alizojran/sensor/float_flowmeter_sim/float_redesign_cfd.png

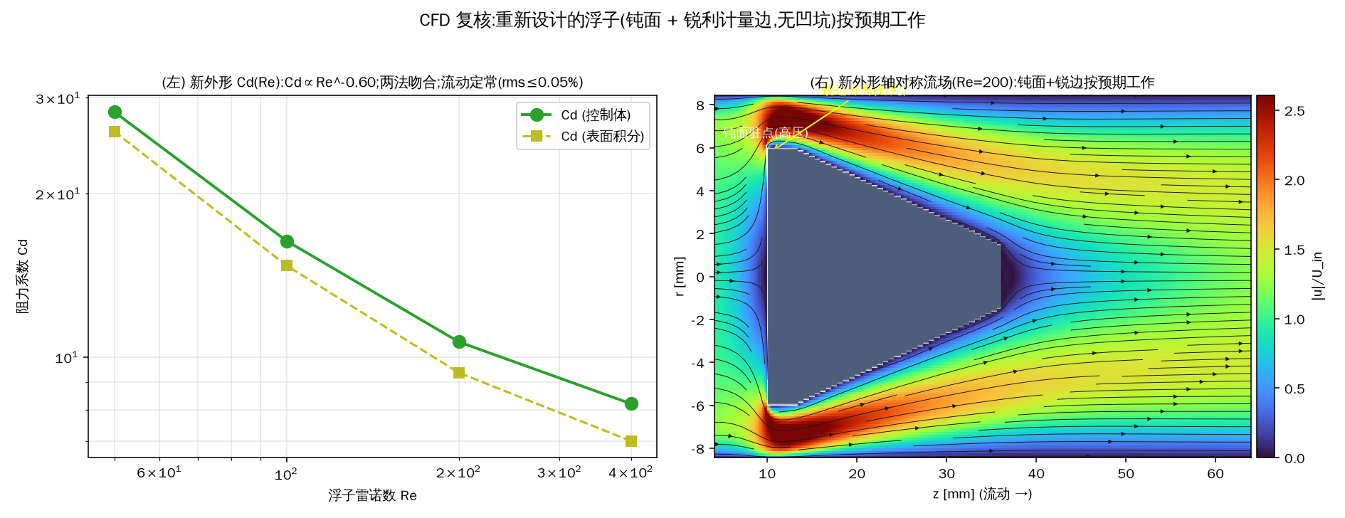
float_flowmeter_sim/float_redesign_cfd.png
