alizojran/sensor/float_flowmeter_sim/float_axisym.png

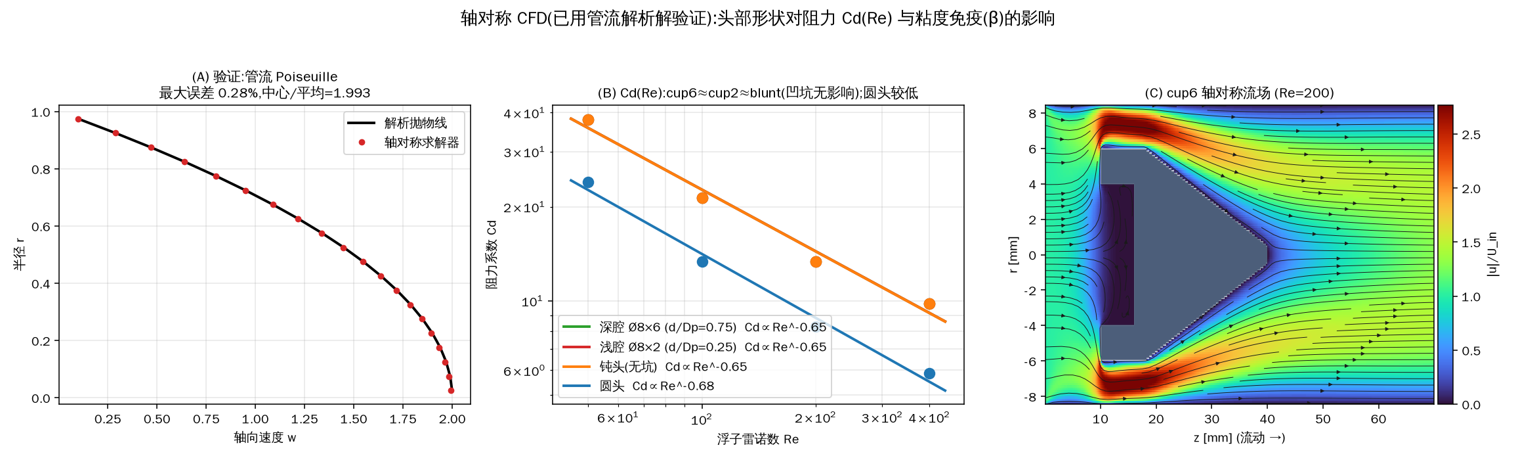
float_flowmeter_sim/float_axisym.png
