alizojran/sensor/float_flowmeter_sim/float_meter_report.pdf

# 弹簧活塞式变截面流量计 — 原理 · 设计 · 精度 · CFD · 重设计(一页总览)

对象:ifm SBZ224 — 弹簧活塞式变截面(机电)流量计,1–50 l/min,水/乙二醇/冷却液,G½,200 bar,IP67,IO-Link。 原理:流体推动弹簧加载的浮子,位置∝流量,磁感应非接触读出 →4–20 mA/IO-Link;弹簧主导→安装方向无关。 方法链:解析精度模型 → 2D LBM 机理 → 参数/对比 A/B → 轴对称 CFD(经 Hagen–Poiseuille 解析解验证,误差 0.28%)。

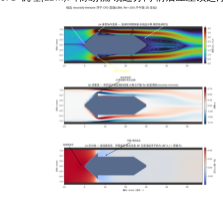
[picture p11: figure]

① 精度模型:锐边浮子 Cd 平、误差小;球形随粘度漂移大

② CFD 机理(LBM):环隙射流·锐边分离·前后压差顶起浮子

③ 轴对称 CFD(管流验证 0.28%):凹坑无影响,环隙主导

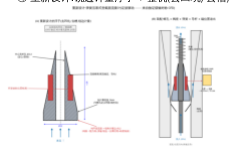
[picture p12: figure]

④ 重新设计:锐边计量浮子 + 整机(去凹坑/去槽) ⑤ 制造图:公差链(环隙 0.2–3.2)·同轴度·锐边

⑥ CFD 复核:新外形(钝面+锐边)按预期工作

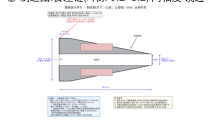
[picture p13: figure]
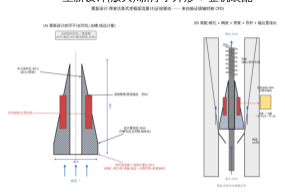
[picture p14: figure]

重新设计(放大):新浮子外形 + 整机装配

关键发现(证据驱动):

- 计量由【环隙=主节流口】主导;前脸细节(锥面槽、前向凹坑)对计量无影响(轴对称 CFD:cup6≈cup2≈blunt,<0.1%)。
- 真正的粘度免疫杠杆 = 【锐利计量边】把分离点钉死;钝迎流面阻力高且更 Re 稳定(blunt>rounded)。
- 2D 平面算出的“210% 脉动/需加深凹坑”是错误几何的假象——轴对称(正确几何)流动定常(rms≈0)。 重设计要点:钝面+90°锐边(Ø12)+短计量柱段+流线锥尾+中心导杆+内置磁铁;去凹坑/去槽(从简、可靠)。

数据/脚本/全部图见 float_flowmeter_sim/(README §1–9, REDESIGN.md)
