alizojran/sensor/float_flowmeter_sim/float_cad_preview.png

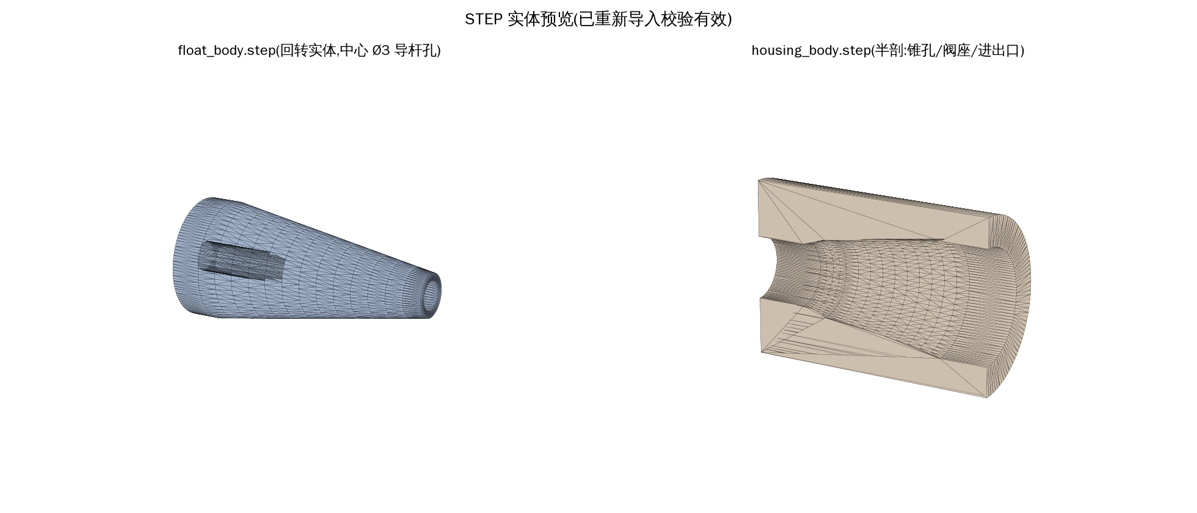
float_flowmeter_sim/float_cad_preview.png
