alizojran/sensor/float_flowmeter_sim/float_cavity_opt.png

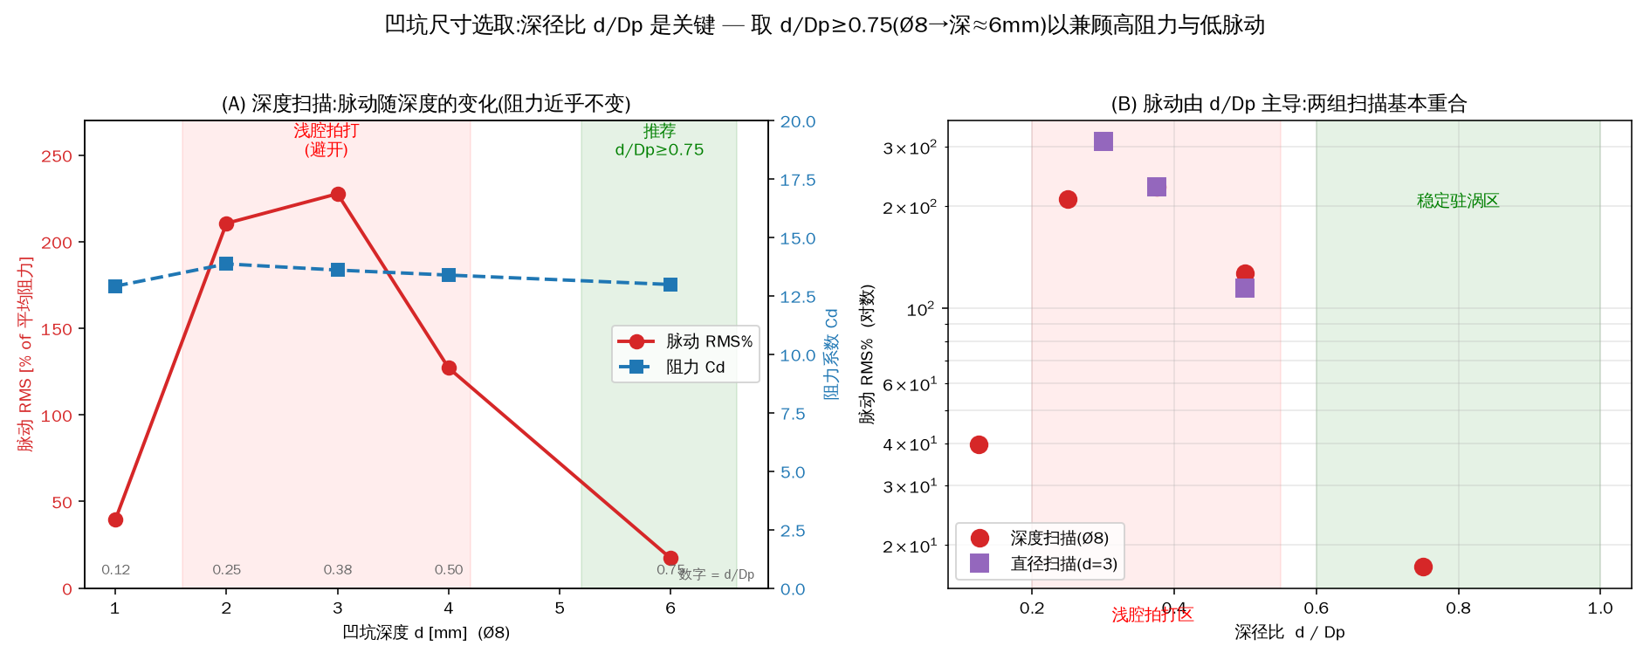
float_flowmeter_sim/float_cavity_opt.png
