alizojran/sensor/float_flowmeter_sim/float_cup_accuracy.png

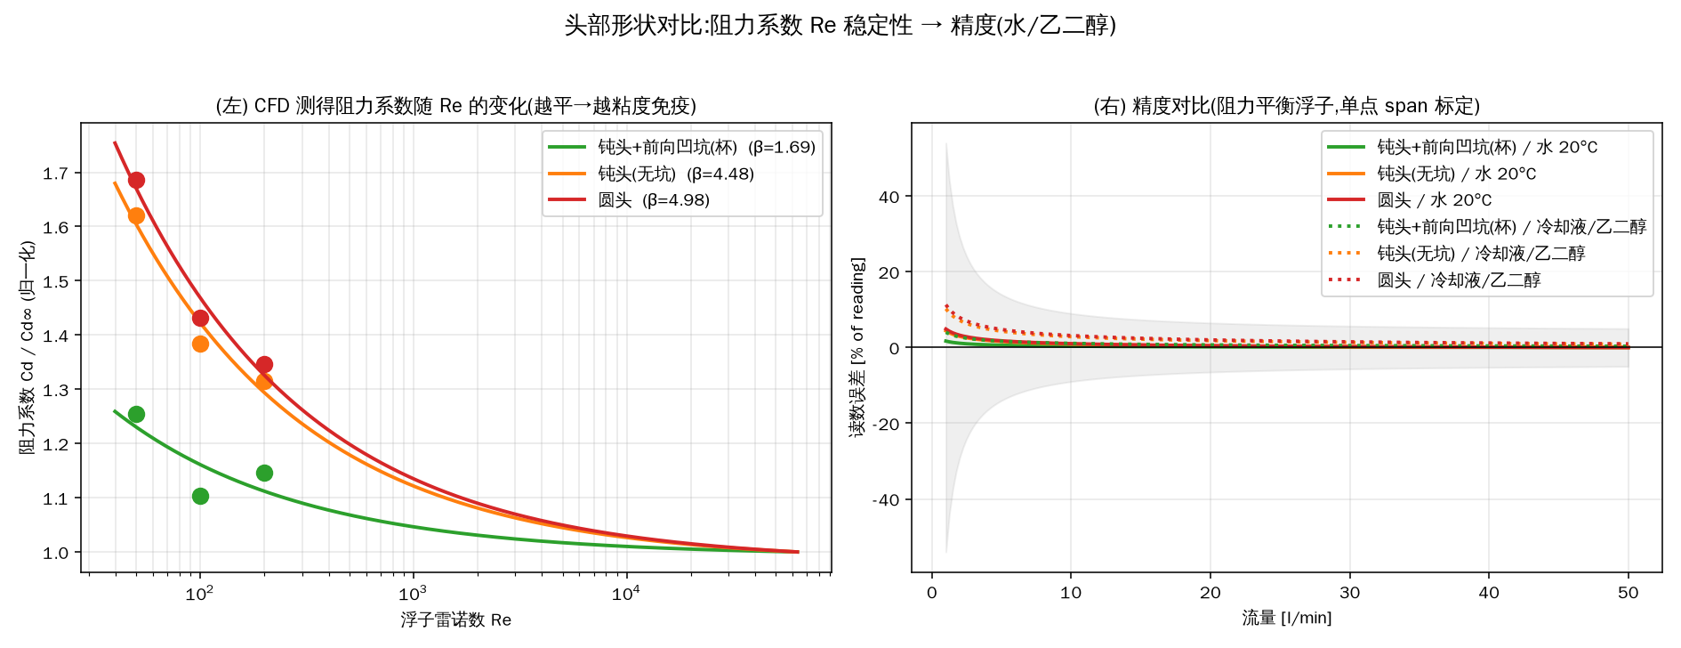
float_flowmeter_sim/float_cup_accuracy.png
