alizojran/sensor/float_flowmeter_sim/float_cup_cfd.png

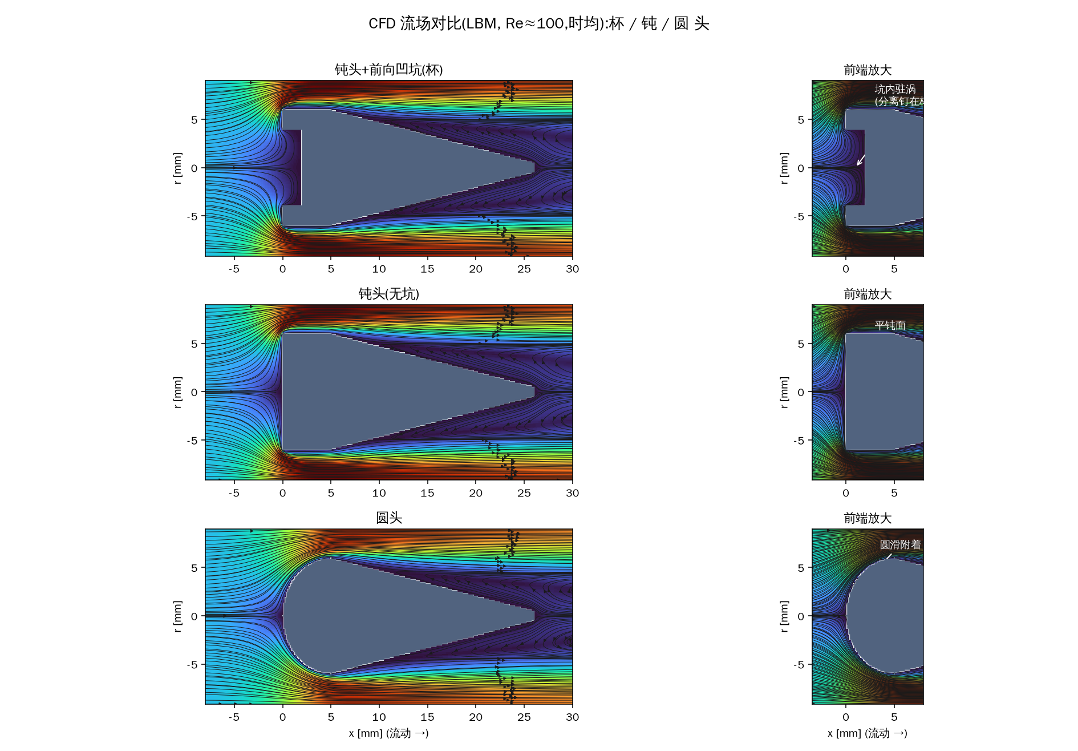
float_flowmeter_sim/float_cup_cfd.png
