alizojran/sensor/float_flowmeter_sim/float_groove_accuracy.png

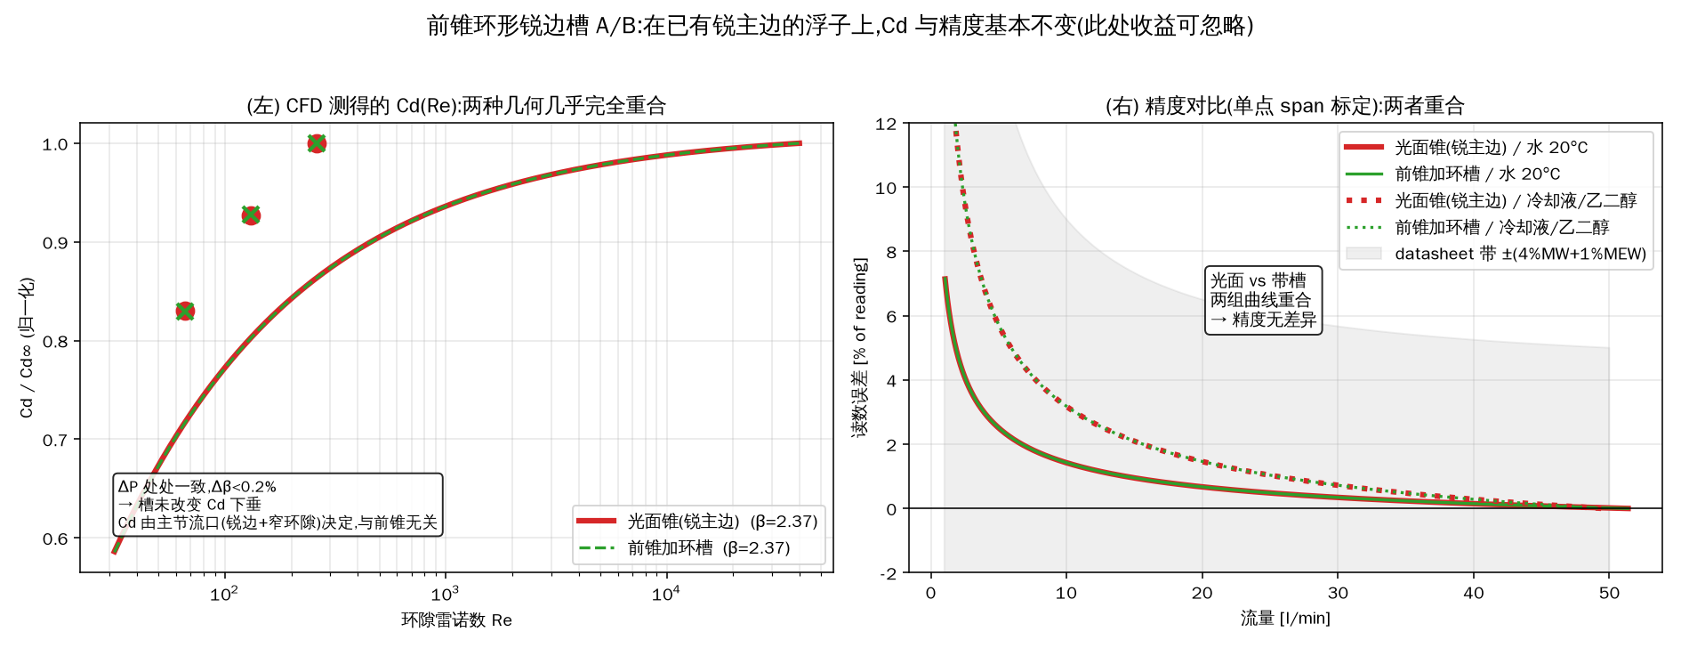
float_flowmeter_sim/float_groove_accuracy.png
