alizojran/sensor/float_flowmeter_sim/float_meter_report.png

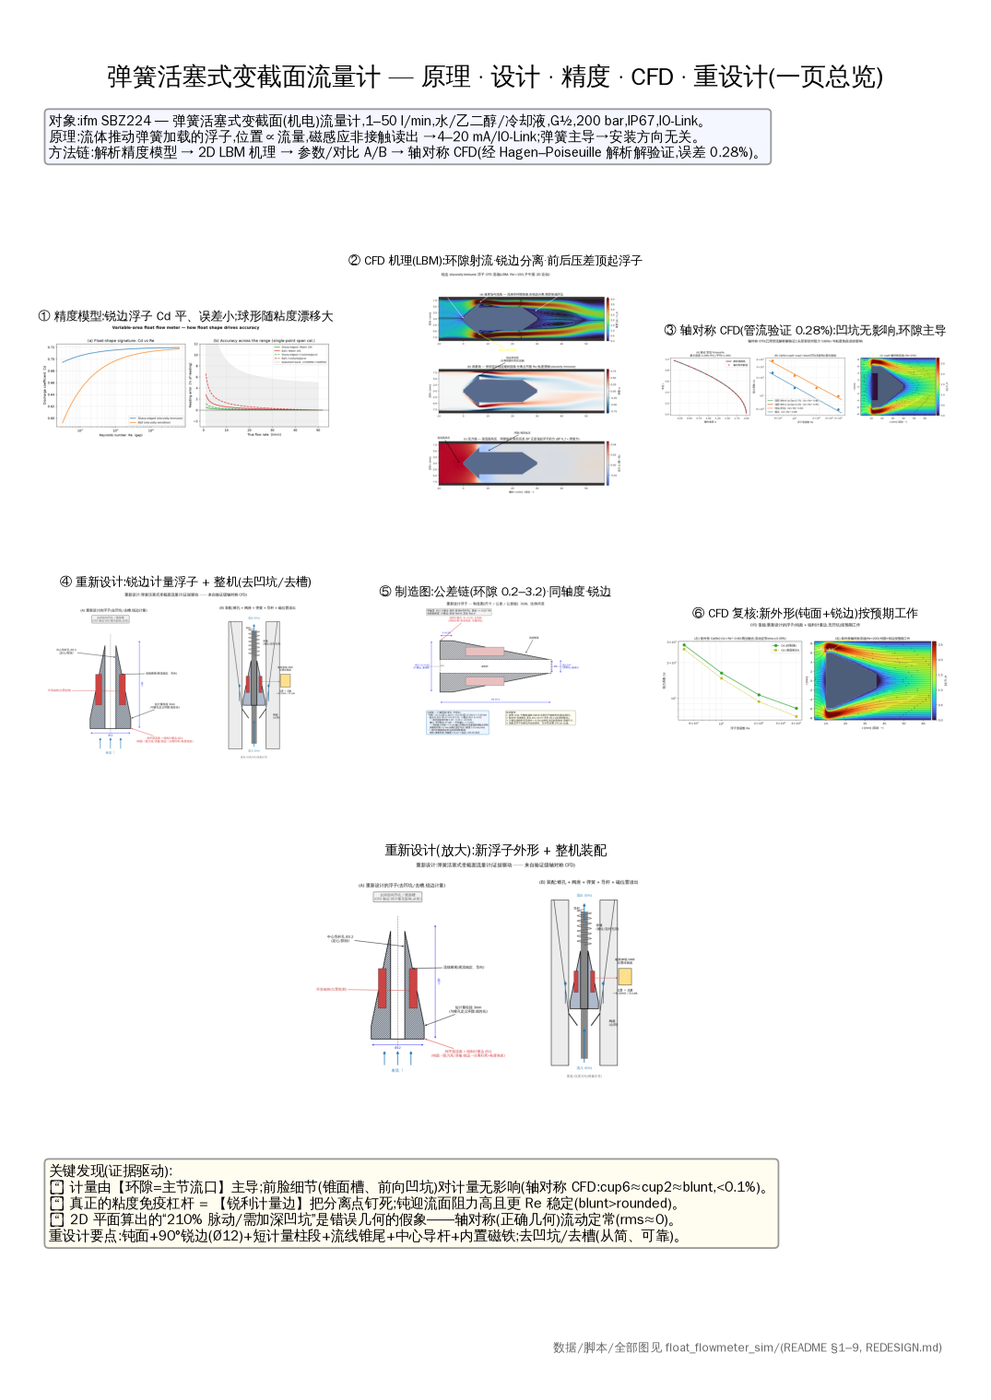
float_flowmeter_sim/float_meter_report.png
