alizojran/sensor/float_flowmeter_sim/float_shape_final.png

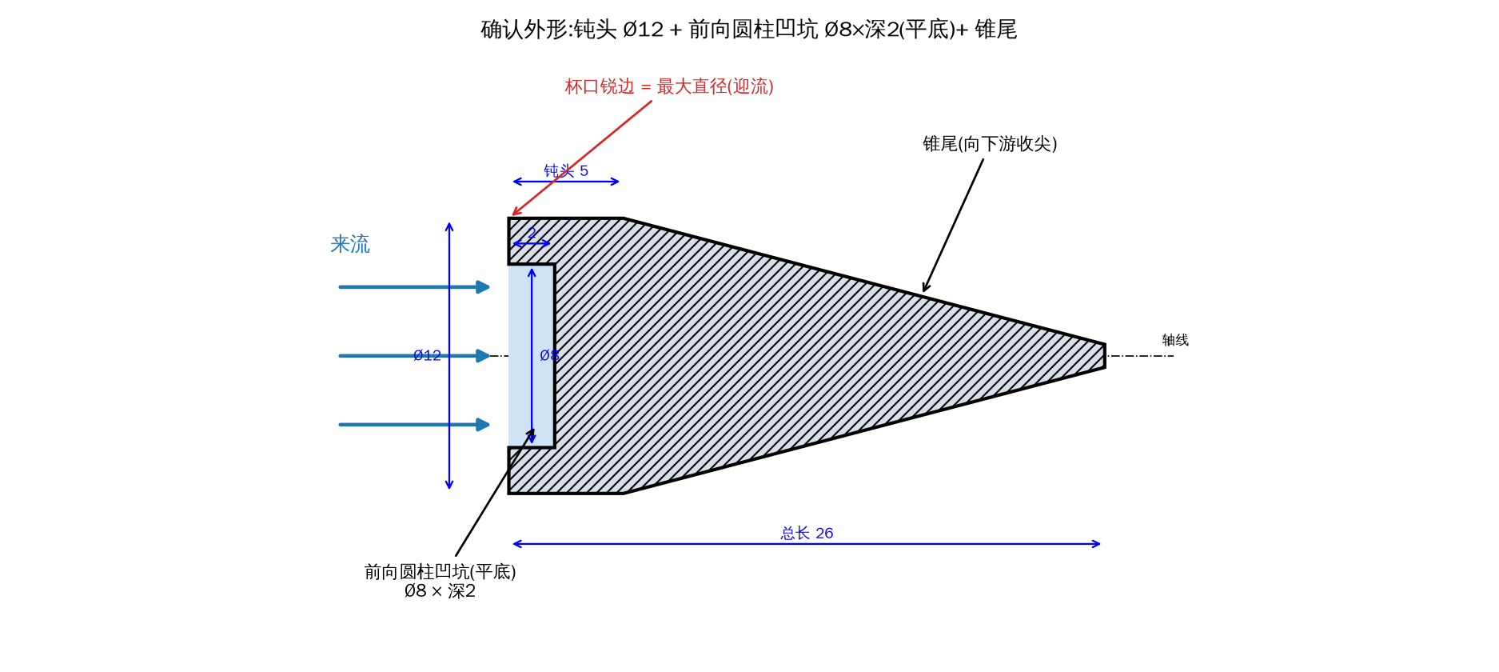
float_flowmeter_sim/float_shape_final.png
