alizojran/sensor/float_flowmeter_sim/float_shape_proposal2.png

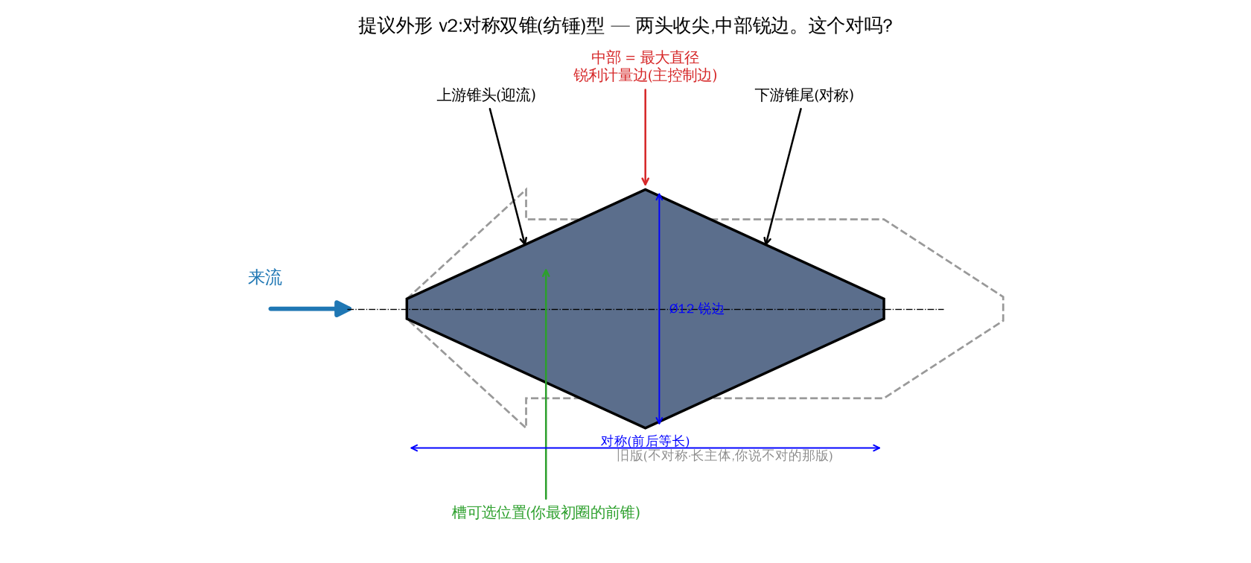
float_flowmeter_sim/float_shape_proposal2.png
