alizojran/sensor/float_flowmeter_sim/float_shape_proposal3.png

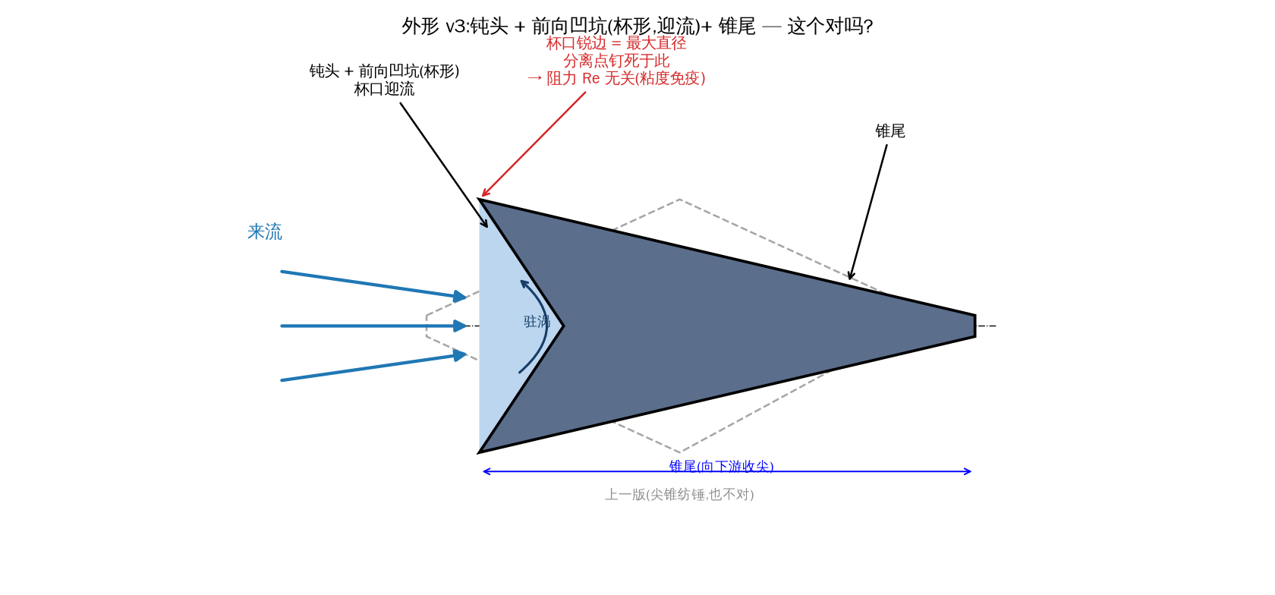
float_flowmeter_sim/float_shape_proposal3.png
