alizojran/sensor/float_flowmeter_sim/float_shape_proposal4.png

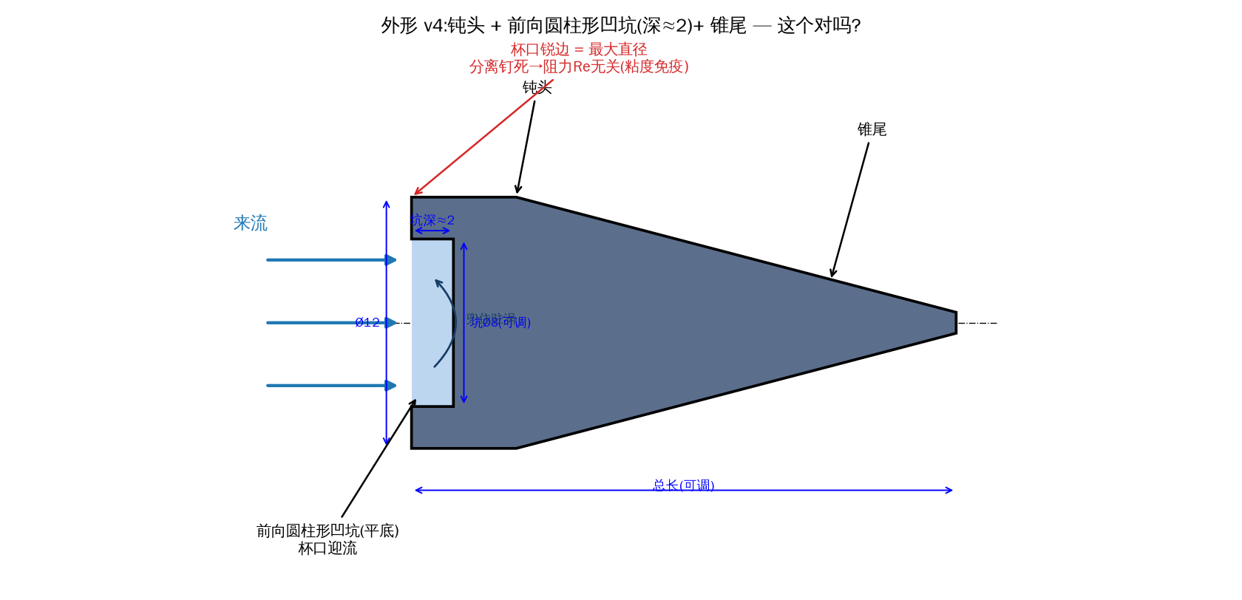
float_flowmeter_sim/float_shape_proposal4.png
