alizojran/sensor/float_flowmeter_sim/float_shape_proposal.png

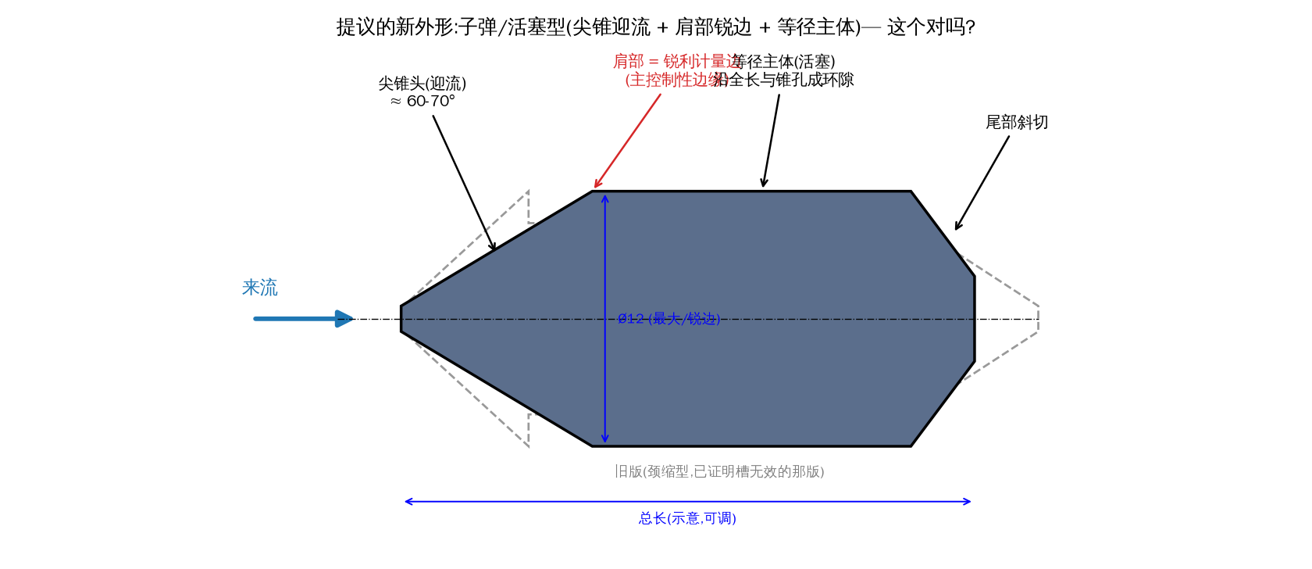
float_flowmeter_sim/float_shape_proposal.png
