alizojran/sensor/float_flowmeter_sim/housing_mfg_drawing.png

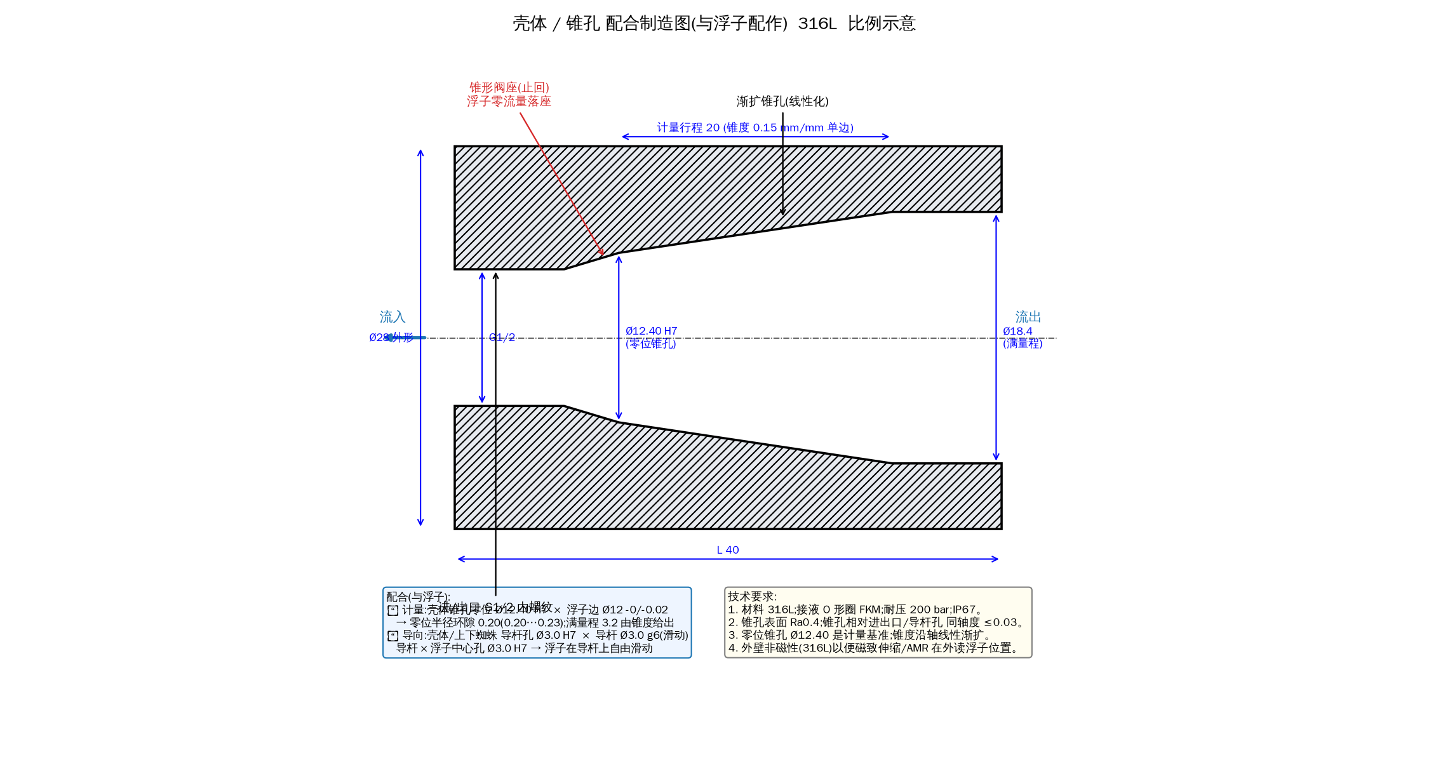
float_flowmeter_sim/housing_mfg_drawing.png
