alizojran/sensor/float_flowmeter_sim/float_body.step

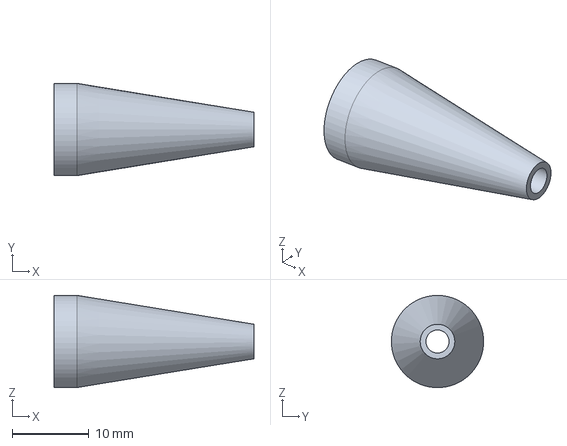
[picture p27: CAD file, 2026-06-14]
float_flowmeter_sim/float_body.step
26.0 x 12.0 x 12.0 mm
