alizojran/sensor/float_flowmeter_sim/float_profile.dxf

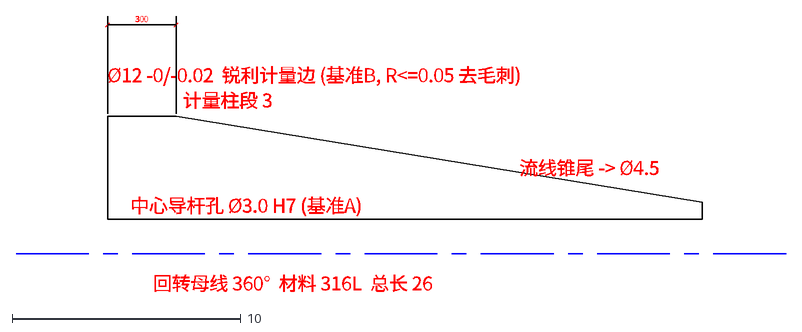
[picture p28: CAD file, 2026-06-14]
float_flowmeter_sim/float_profile.dxf
Ø12 -0/-0.02 锐利计量边 (基准B, R<=0.05 去毛刺)
计量柱段 3
流线锥尾 -> Ø4.5
中心导杆孔 Ø3.0 H7 (基准A)
回转母线 360° 材料 316L 总长 26
300
