alizojran/sensor/float_flowmeter_sim/housing_bore_profile.dxf

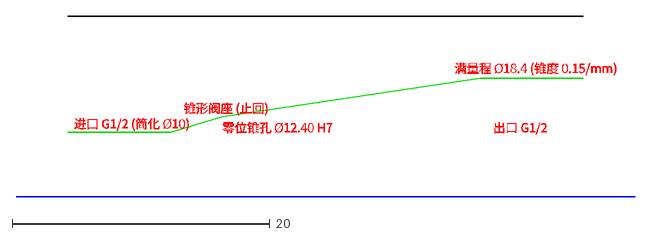
[picture p29: CAD file, 2026-06-14]
float_flowmeter_sim/housing_bore_profile.dxf
进口 G1/2 (简化 Ø10)
锥形阀座 (止回)
零位锥孔 Ø12.40 H7
满量程 Ø18.4 (锥度 0.15/mm)
出口 G1/2
