alizojran/sensor/float_flowmeter_sim/housing_body.step

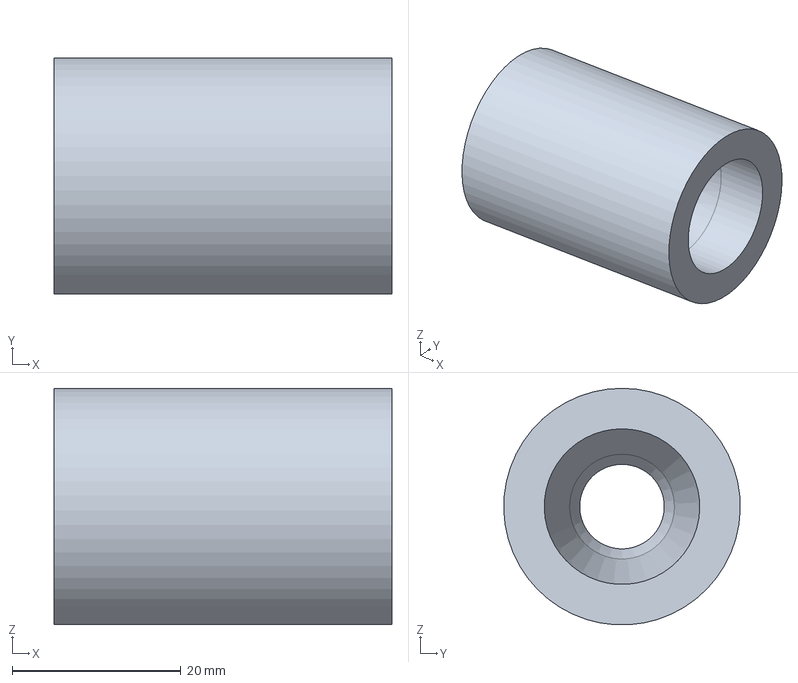
[picture p30: CAD file, 2026-06-14]
float_flowmeter_sim/housing_body.step
40.0 x 28.0 x 28.0 mm
