alizojran/sensor/float_flowmeter_sim/float_deep_verify.png

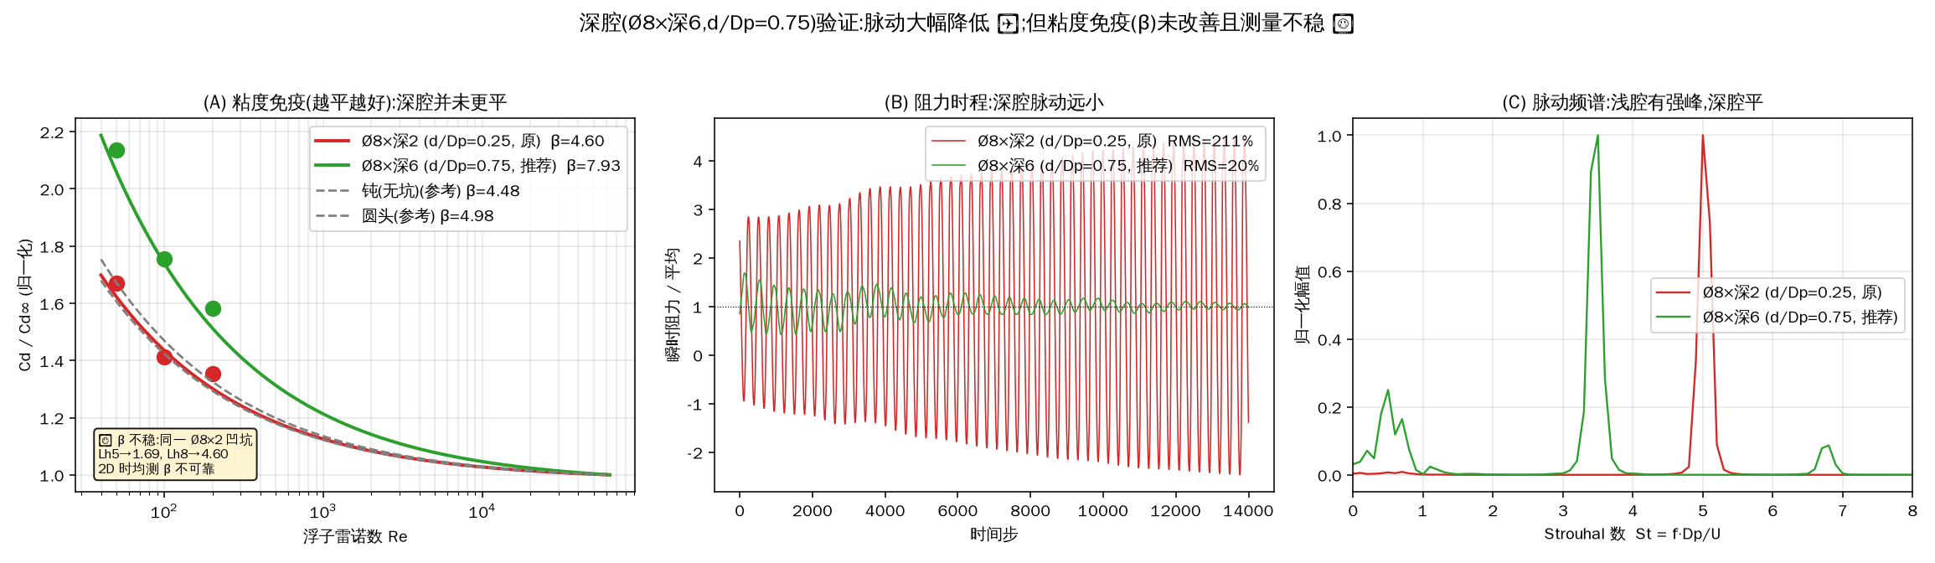
float_flowmeter_sim/float_deep_verify.png
