alizojran/sensor/(commit log)

2026-06-13 Add float flow-meter shape design and accuracy simulation
    Spring-loaded variable-area (float/piston) flow meter modeled after the
    ifm SBZ224. Includes float-shape design requirements, a sharp-edged
    viscosity-immune float design, and a Python simulation of reading
    accuracy vs flow (1-50 l/min) for water and glycol/coolant, showing how
    the float's Cd(Re) signature drives error.
2026-06-13 Add cross-section drawing of the sharp-edged viscosity-immune float
    Two-panel engineering drawing: (A) float longitudinal section with
    dimensions and feature callouts (sharp metering edge, 60-deg sealing
    cone/check valve, ring magnet, guide bore, streamlined tail); (B) the
    float working inside the tapered bore with seat, spring, flow path and
    magnetic position sensor.
2026-06-13 Add LBM CFD solver and flow-field plotting for the float
    D2Q9 BGK lattice-Boltzmann solver (numpy) of the meridional-plane flow
    around the sharp-edged float in the bore, plus a plotting script for the
    velocity/streamline and vorticity fields. Generated .npz/.log artifacts
    are gitignored.
2026-06-13 Render CFD flow field (speed/streamlines, vorticity, pressure) and document
    3-panel flow field around the float at Re~150: gap jet (~6.5x inlet),
    fixed separation at the sharp edge, recirculation wake, and the
    fore-aft pressure difference that lifts the float. Updates README.
2026-06-13 Add proposed bullet/piston float outline for shape confirmation
2026-06-13 Shape proposal v2: symmetric bi-conical (spindle) float for confirmation
2026-06-14 Time-average drag and fields in cup study (forward cavity flow is unsteady)
2026-06-14 Cup A/B/C result: forward cavity gives highest + most Re-stable drag (viscosity-immune)
    Time-averaged drag from CFD: cup Cd_inf=12 beta=1.69, blunt 9.2/4.48,
    rounded 5.6/4.98. The forward cylindrical cavity both raises drag (sensitivity)
    and flattens Cd(Re) (viscosity immunity); plain bluntness alone does not.
    Adds flow-field + Cd(Re)/accuracy figures and README section 6.
2026-06-14 Cavity sizing: pulsation governed by d/Dp; recommend d/Dp>=0.75 (Ø8 -> d~6mm)
    Depth/diameter sweep with time-resolved drag: pulsation RMS peaks at
    d/Dp~0.25-0.5 (>200%) and collapses to ~17% at d/Dp>=0.75 while Cd stays ~13.
    The original 2mm pit (d/Dp=0.25) sits in the worst regime; deepen to ~6mm.
2026-06-14 Add axisymmetric (r-z) NS solver + float drag sweep (Poiseuille-validated: 0.19% error)
    Staggered MAC fractional-step projection solver for axisymmetric incompressible
    flow, validated against the analytic Hagen-Poiseuille parabola (max err 0.19%,
    centreline/mean 1.995). Geometry (cup6/cup2/blunt/rounded), CV + surface drag
    cross-check, plotting. Built to resolve the float viscosity-immunity (beta)
    question correctly for a body of revolution.
2026-06-14 Axisymmetric CFD result: forward cavity is irrelevant to drag; 2D pulsation was an artifact
    Validated axisymmetric solver (Poiseuille 0.28%) shows cup6=cup2=blunt drag to
    <0.1% across Re 50-400 -> the forward cavity has no metering effect (gap/blockage
    dominates). Flow is steady (rms~0) -> the 2D-planar 210% pulsation was a planar
    artifact. rounded has lower drag (gross nose shape matters, not the cavity).
    Corrects sections 6-8. README section 9.
2026-06-14 Evidence-based redesign: sharp-edged float (no cavity/groove) + assembly
    Redesigns the float and meter from the validated findings: keep the sharp
    metering edge (viscosity-immunity lever), blunt windward face (higher/steadier
    drag than rounded), tapered bore + spring (orientation-independent); DROP the
    forward cavity and cone groove (CFD: no metering effect). Adds drawing + REDESIGN.md
    with an evidence->decision table.
2026-06-14 Add manufacturing drawing (tolerance chain), redesign CFD re-check, one-page PDF report
    (1) float_mfg_drawing: dimensioned float with metering-gap tolerance chain
    (0.2-3.2mm), concentricity to guide bore, sharp-edge spec, fits/notes.
    (2) Axisymmetric CFD re-check of the redesigned shape: steady (rms<=0.05%),
    two drag methods agree, Cd proportional Re^-0.6 -> blunt face + sharp edge work as intended.
    (3) project_report: one-page A4 PDF summarising principle->design->accuracy->CFD->redesign.
2026-06-14 Add CAD export: float/housing DXF (revolve profiles) + STEP solids + housing mating drawing
    float_cad_export.py: ezdxf 2D meridional sketches + cadquery revolved STEP solids
    (float_body.step V=1470, housing_body.step V=17707; re-import validated).
    housing_mfg_drawing.py: housing/bore mating drawing with fits & tolerance chain.
    CAD_FILES.md documents files, parametric profiles, and float<->bore fits.
    [float_body.step, float_profile.dxf, housing_body.step, housing_bore_profile.dxf]
